ShenYiTan/fpv-bee25-aio-build-log/media/IMG_20251018_192319.jpg

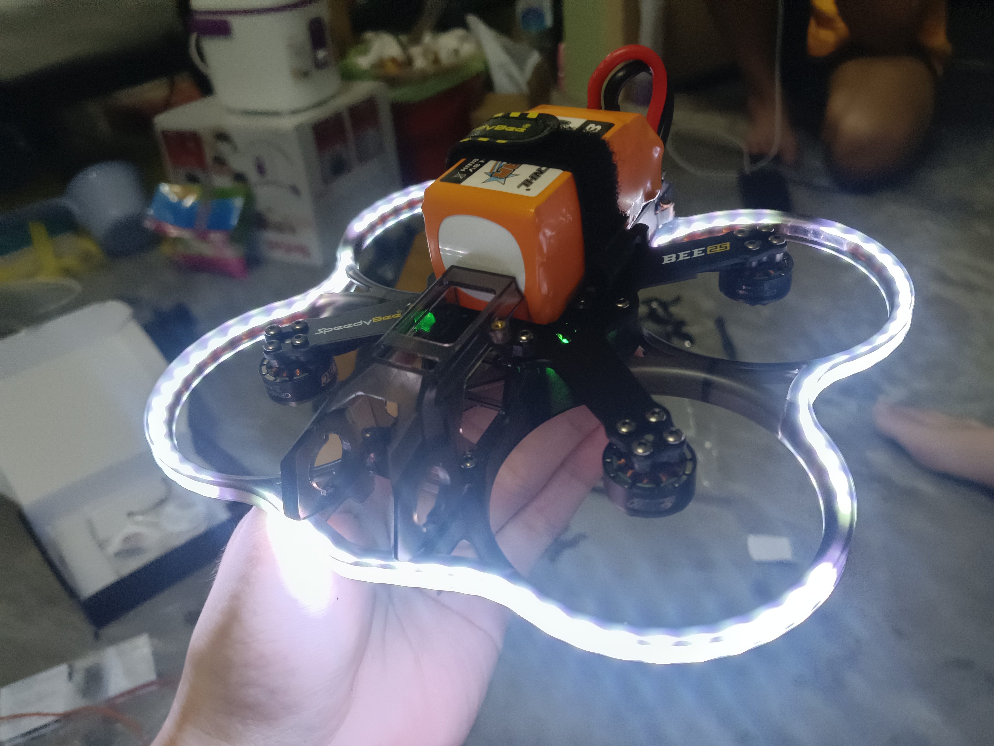
media/IMG_20251018_192319.jpg
