ShenYiTan/fpv-bee25-aio-build-log/media/IMG_20251018_011021.jpg

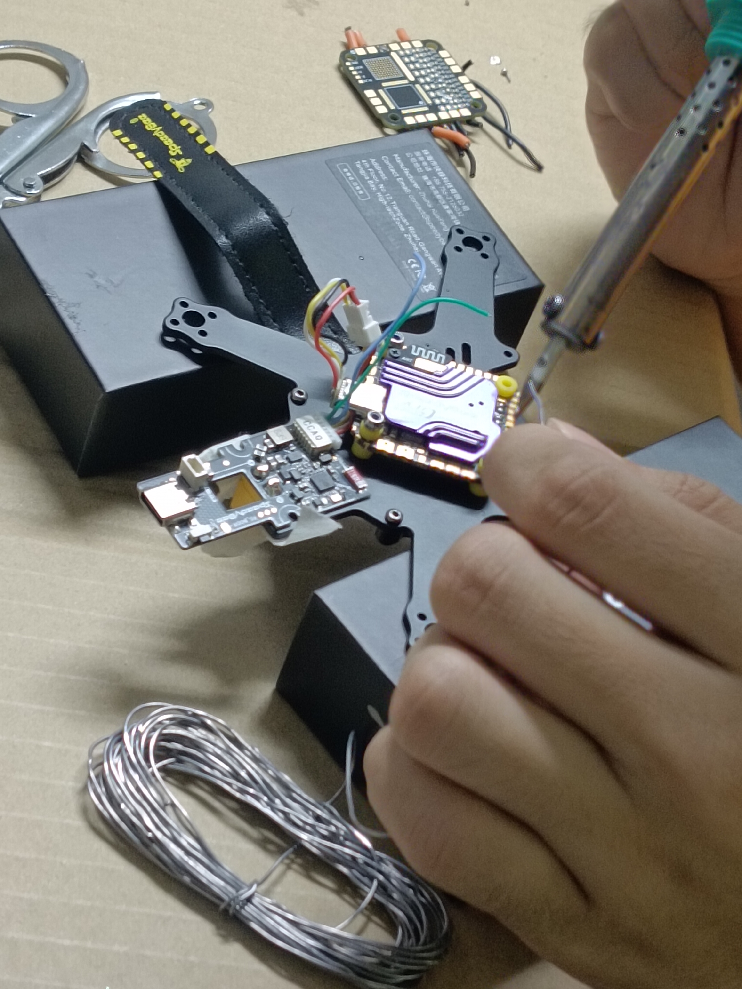
media/IMG_20251018_011021.jpg
