ShenYiTan/fpv-bee25-aio-build-log/README.md

# fpv-bee25-aio-build-log
Documentation covering the entire process: parts selection, physical assembly, soldering, Betaflight configuration, and troubleshooting problem(including motor failure and protection solutions).
