ShenYiTan/fpv-bee25-aio-build-log/Landing Pad 3D files/readme.md

This folder contains the 3D printable files (STLs) used to create custom landing pads for the SpeedyBee 25.

We used these parts to increase ground clearance and protect the motors/frame after diagnosing the motor burnout issue (see the main build log for details).

## ✨ Credit

The design for the landing pads was sourced from the open-source community.

**Original Model:** Improved SpeedyBee Bee25 Landing Pads
**Source Link:** [MakerWorld](https://makerworld.com/en/models/1162609-improved-speedybee-bee25-landing-pads#profileId-1169240)
