ShenYiTan/fpv-bee25-aio-build-log/media/IMG_20251018_160642.jpg

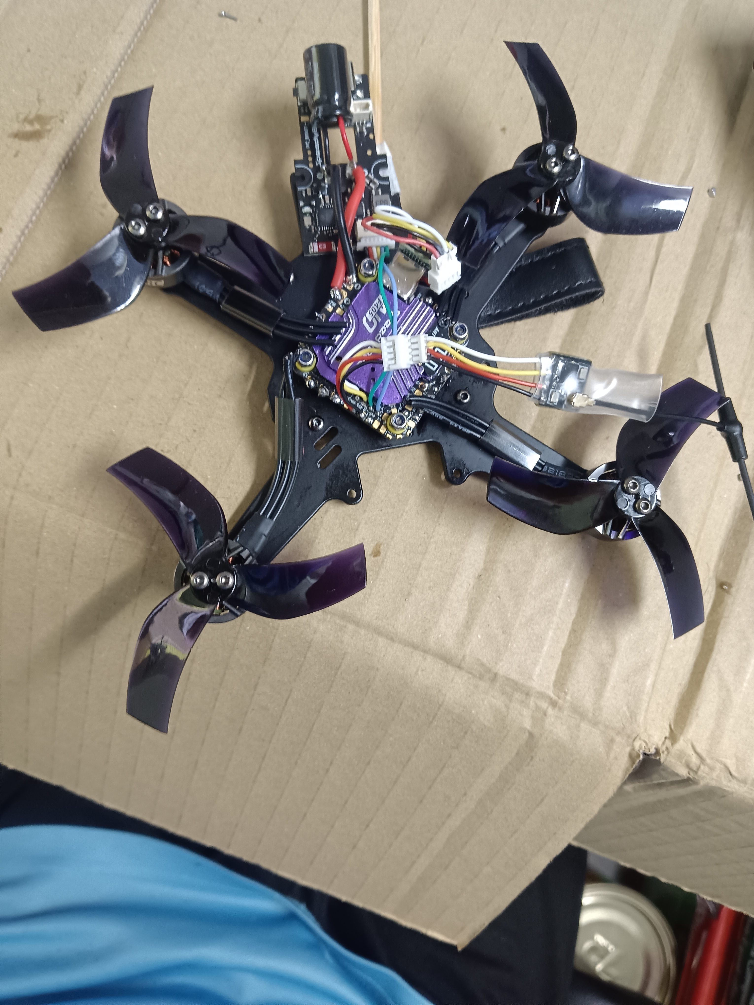
media/IMG_20251018_160642.jpg
