ShenYiTan/fpv-bee25-aio-build-log/media/IMG_20251101_162404.jpg

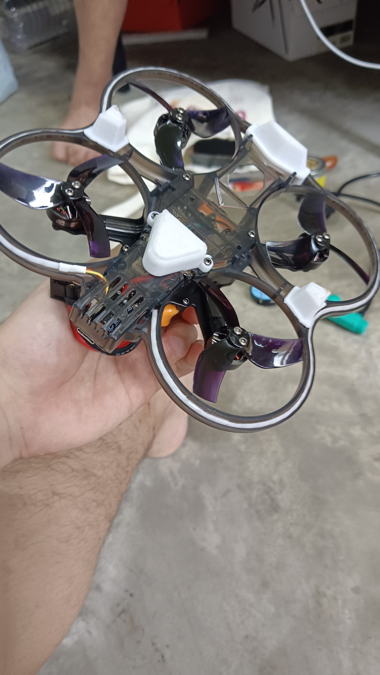
media/IMG_20251101_162404.jpg
