ShenYiTan/fpv-bee25-aio-build-log/media/Screenshot 2025-12-02 195238.png

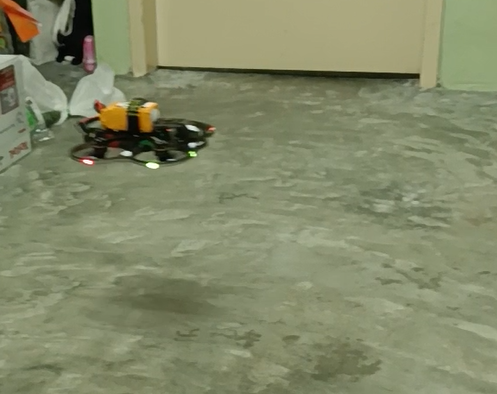
media/Screenshot 2025-12-02 195238.png
