ShenYiTan/fpv-bee25-aio-build-log/Landing Pad 3D files/obj_3_BEE25 脚垫3角.stl_1.stl

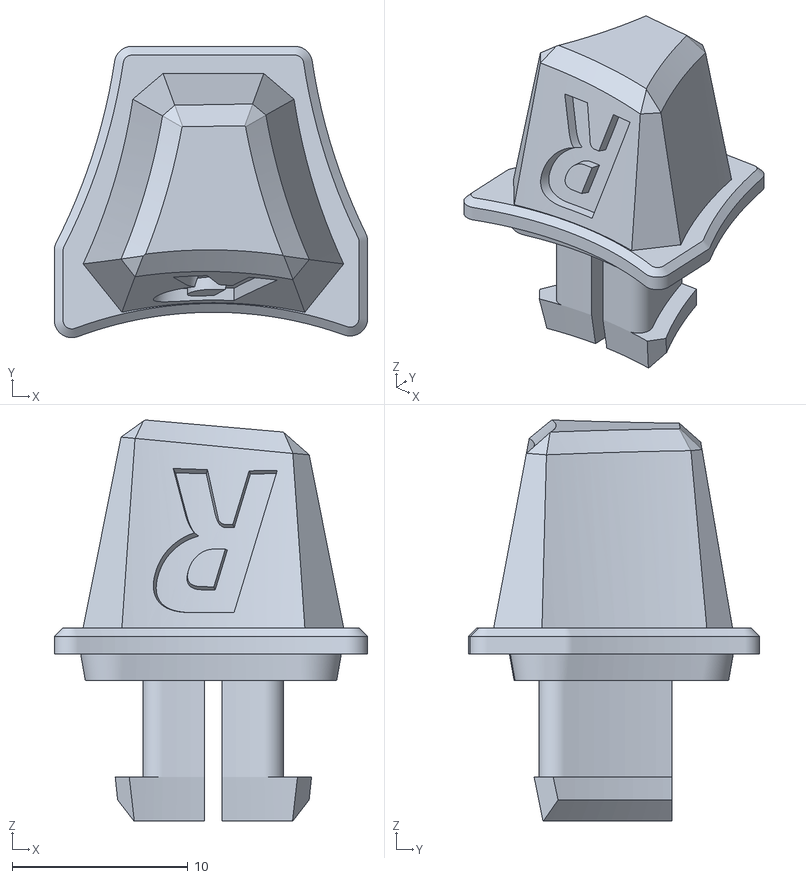
[picture p20: CAD file, 2025-12-01]
Landing Pad 3D files/obj_3_BEE25 脚垫3角.stl_1.stl
17.8 x 16.6 x 22.8
