ShenYiTan/fpv-bee25-aio-build-log/Landing Pad 3D files/obj_2_加长前脚垫.stl

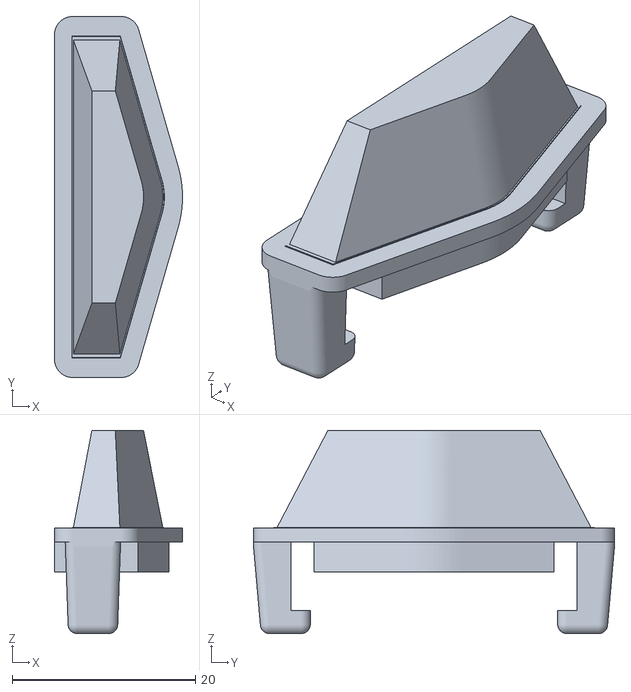
[picture p21: CAD file, 2025-12-01]
Landing Pad 3D files/obj_2_加长前脚垫.stl
14.0 x 39.4 x 22.2
