ShenYiTan/fpv-bee25-aio-build-log/Landing Pad 3D files/obj_1_Bee 25脚垫(1).stl

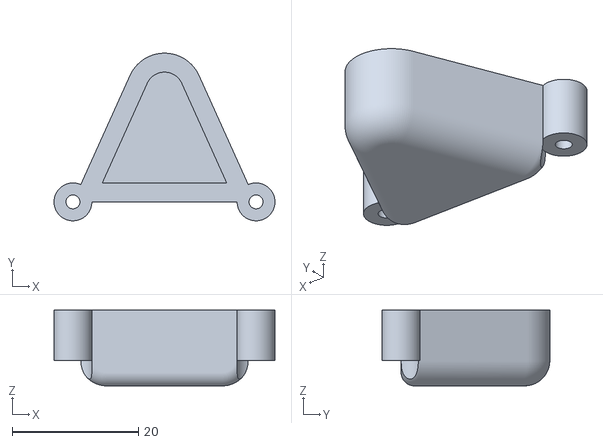
[picture p22: CAD file, 2025-12-01]
Landing Pad 3D files/obj_1_Bee 25脚垫(1).stl
35.0 x 26.6 x 12.0
