ShenYiTan/fpv-bee25-aio-build-log/Landing Pad 3D files/obj_4_BEE25 脚垫3角.stl_2.stl

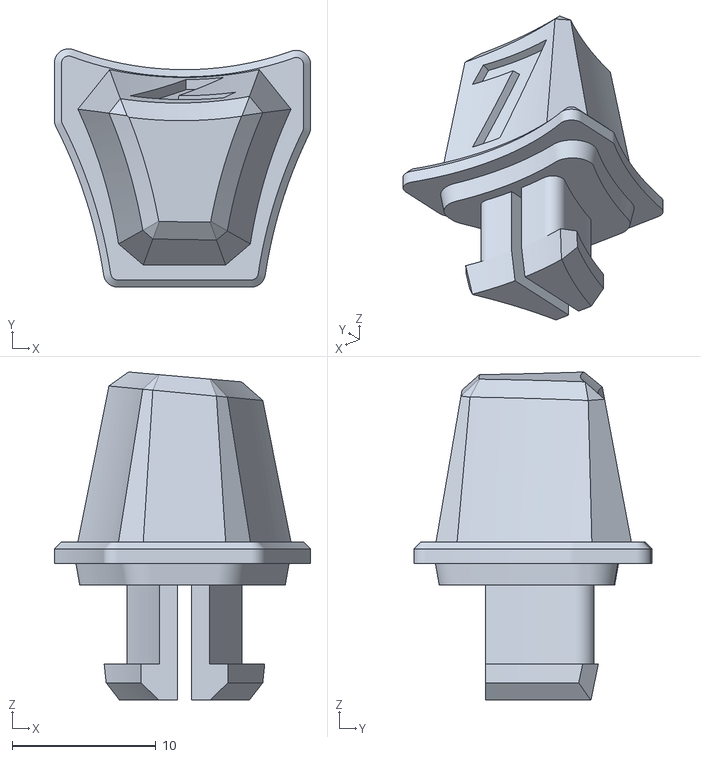
[picture p23: CAD file, 2025-12-01]
Landing Pad 3D files/obj_4_BEE25 脚垫3角.stl_2.stl
17.8 x 16.6 x 22.8
